WY6Y/cw-paddle-pico/case/uno-base.stl

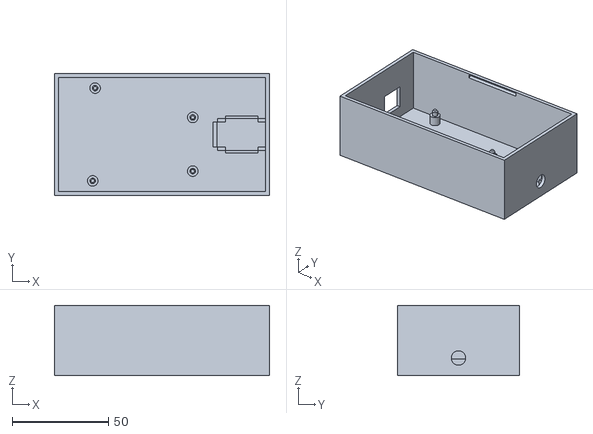
[picture p4: CAD file, 2026-11-01]
case/uno-base.stl
111.9 x 63.3 x 36.6
