WY6Y/cw-paddle-pico/case/uno-lid.stl

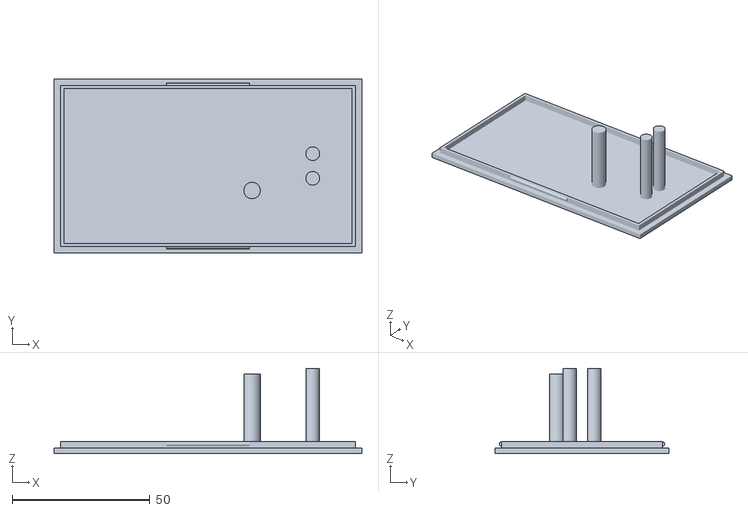
[picture p5: CAD file, 2026-11-01]
case/uno-lid.stl
111.9 x 63.3 x 31.0
