WY6Y/cw-paddle-pico/case/lid-2jack.stl

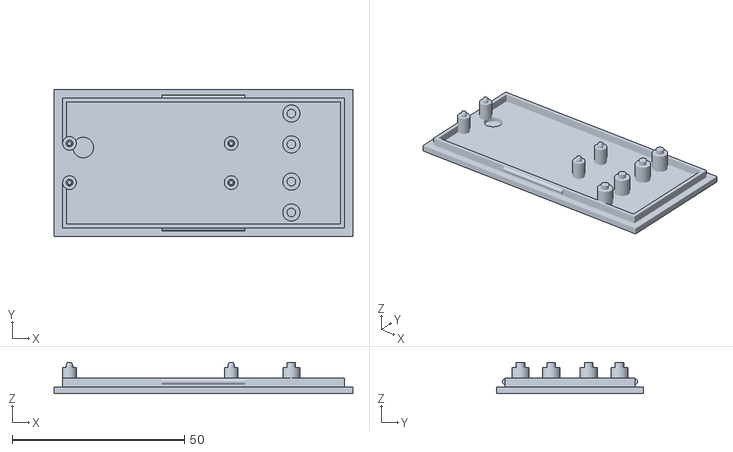
[picture p6: CAD file, 2026-10-31]
case/lid-2jack.stl
86.9 x 42.6 x 9.09
