WY6Y/cw-paddle-pico/case/lid-1jack.stl

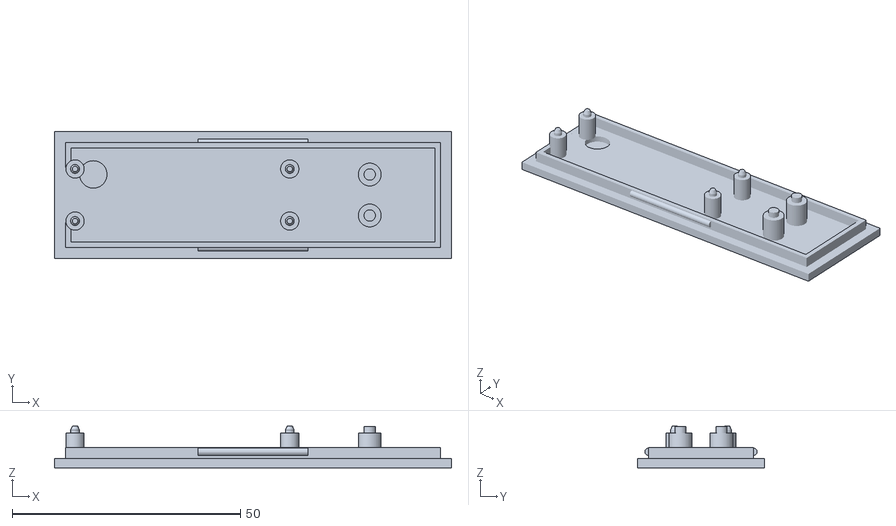
[picture p7: CAD file, 2026-10-31]
case/lid-1jack.stl
86.9 x 27.8 x 9.09
