WY6Y/cw-paddle-pico/case/base-2jack.stl

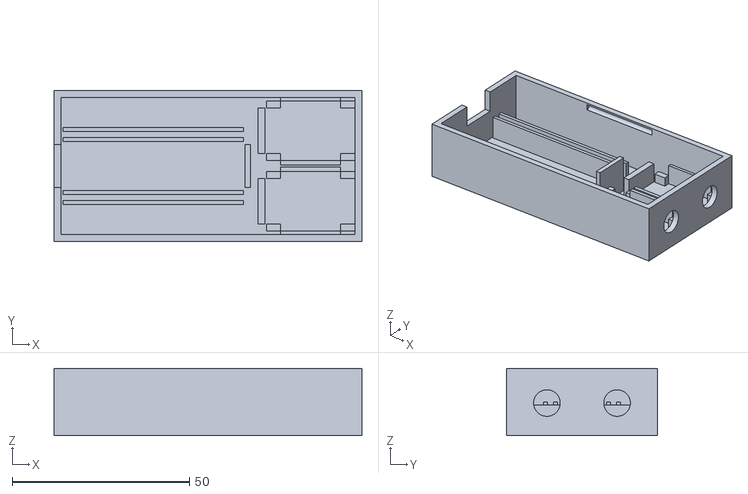
[picture p8: CAD file, 2026-10-31]
case/base-2jack.stl
86.9 x 42.6 x 19.0
