WY6Y/cw-paddle-pico/case/base-1jack.stl

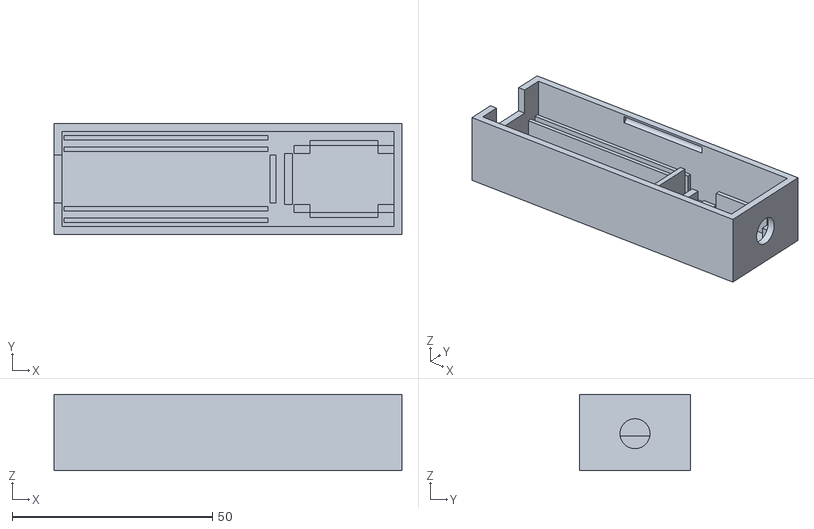
[picture p9: CAD file, 2026-10-31]
case/base-1jack.stl
86.9 x 27.8 x 19.0
