WY6Y/cw-paddle-pico/src/tusb_config.h

#ifndef TUSB_CONFIG_H
#define TUSB_CONFIG_H

#define CFG_TUSB_RHPORT0_MODE     OPT_MODE_DEVICE
#define CFG_TUSB_OS               OPT_OS_PICO
#define CFG_TUD_ENABLED           1
#define CFG_TUD_ENDPOINT0_SIZE    64

#define CFG_TUD_CDC               0
#define CFG_TUD_MSC               0
#define CFG_TUD_HID               0
#define CFG_TUD_MIDI              1
#define CFG_TUD_VENDOR            0

#define CFG_TUD_MIDI_RX_BUFSIZE   64
#define CFG_TUD_MIDI_TX_BUFSIZE   64

#endif
