WY6Y/cw-paddle-pico/(commit log)

2026-10-31 WY6Y CW Paddle: Pico 2 USB MIDI paddle firmware for AetherSDR
2026-10-31 Add parametric 3D-printed case (1 or 2 jacks)
    [base-1jack.stl, base-2jack.stl, case.scad, lid-1jack.stl, lid-2jack.stl]
2026-10-31 Case: Pico H header rails and lid pegs instead of standoffs
    [base-1jack.stl, base-2jack.stl, case.scad, lid-1jack.stl, lid-2jack.stl]
2026-10-31 Case: fit the SmartCool jack breakout from its drawing (lid pegs in board holes, edge ledges, 7.5 mm hole)
    [base-1jack.stl, base-2jack.stl, case.scad, lid-1jack.stl, lid-2jack.stl]
2026-10-31 Remove stale case preview (showed the first, standoff design)
2026-10-31 Case: snap latch for the lid, snug tapered Pico pegs
    Friction lip alone didn't hold the lid. Pico pegs were 1.6 mm in 2.1 mm
    holes, so only the two that sat off-centre gripped.
    [base-1jack.stl, base-2jack.stl, case.scad, lid-1jack.stl, lid-2jack.stl]
2026-10-31 Case: jack-side lid posts shortened to the Pico posts' length (lid wouldn't close)
    [case.scad, lid-1jack.stl, lid-2jack.stl]
2026-11-01 README: as-built left-handed wiring, AetherSDR Load/reconnect notes
2026-11-01 Swap dit/dah to GP3/GP2 for the soldered paddle; README as-built, flux and Pico 2 W LED notes
    [main.c]
2026-11-01 Key-down safety: stuck-lever cutoff, released-state resync, USB re-attach on stall, watchdog; Pico 2 W LED build
    [main.c]
2026-11-01 Arduino Uno R3 stand-in: serial sketch, serial-to-MIDI bridge, dupont-friendly case
    [uno-base.stl, uno-lid.stl, uno_case.scad]
2026-11-03 README for builders: parts, wiring diagram, prebuilt UF2 flashing, per-OS checks, Night Copy use, case renders
2026-11-03 Don't treat an unopened MIDI port as a stalled link
    With no program holding the port open the host never reads, the 1 s resync
    filled the TX FIFO and the stall check re-attached USB every ~10 s. Only
    arm the stall check once the host has taken more notes than the FIFO plus
    one in-flight transfer can hold unread.
    [main.c]
